robot-dexterity/tactile-bench/assets/Dobot MG400 rig/End flange/MG400 Calibration Servo Mount.stl

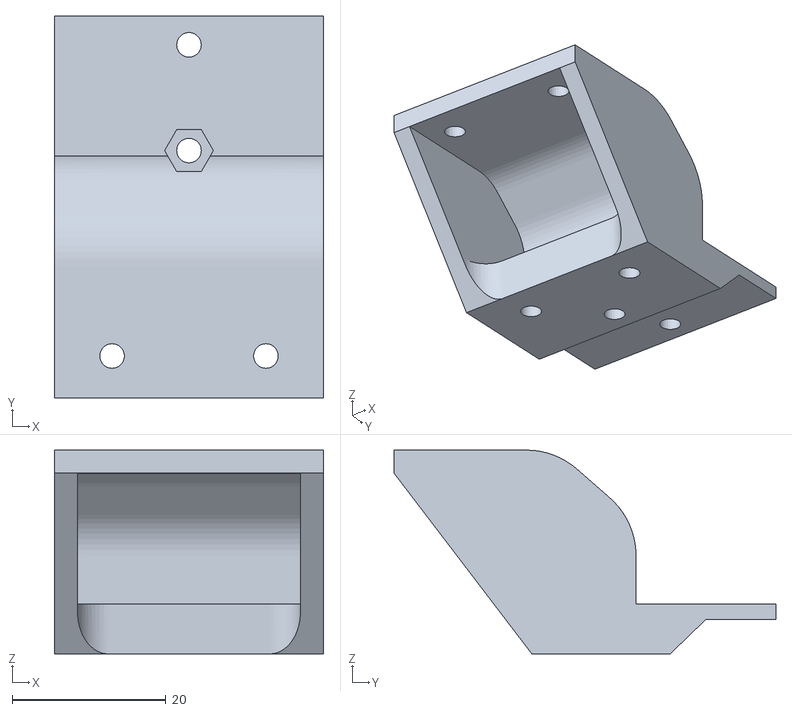
[picture p1: CAD file, 2026-10-21]
assets/Dobot MG400 rig/End flange/MG400 Calibration Servo Mount.stl
35.0 x 49.7 x 26.5
