robot-dexterity/tactile-bench/assets/Dobot MG400 rig/MG400 Baseplate setup with workspace.stl

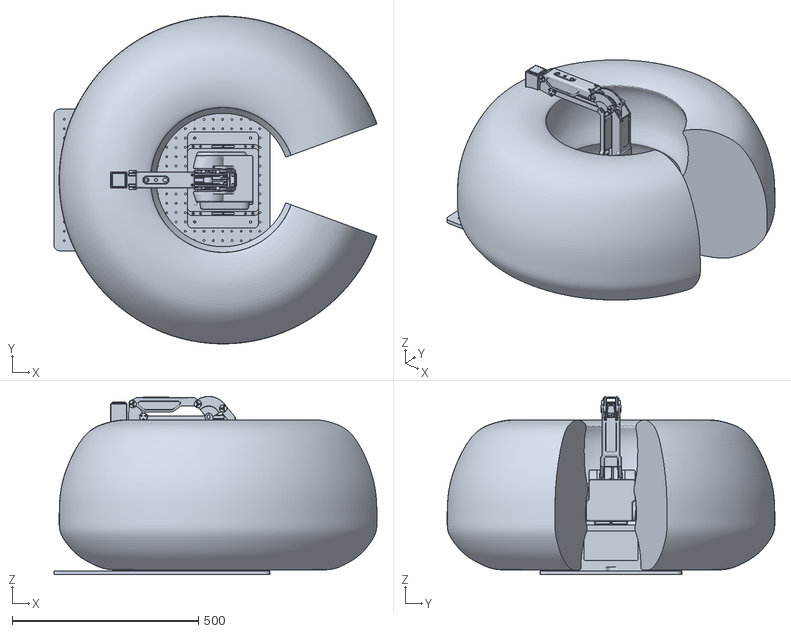
[picture p2: CAD file, 2026-10-21]
assets/Dobot MG400 rig/MG400 Baseplate setup with workspace.stl
866.7 x 879.4 x 478.0
