robot-dexterity/tactile-bench/assets/Dobot MG400 rig/Standoffs/52mmStandOff.step

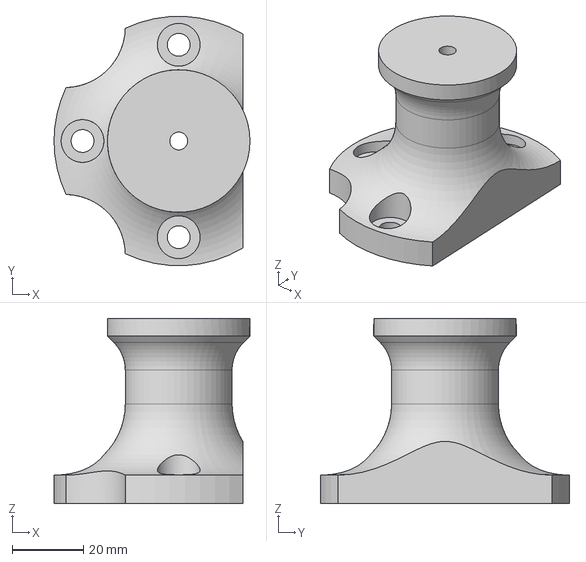
[picture p4: CAD file, 2026-10-21]
assets/Dobot MG400 rig/Standoffs/52mmStandOff.step
55.0 x 69.9 x 52.0 mm
