robot-dexterity/tactile-bench/assets/Dobot MG400 rig/End flange/MG400 End Flange.step

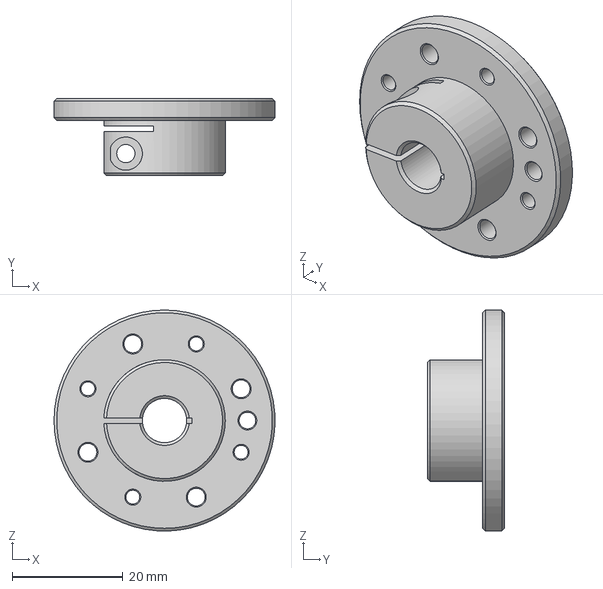
[picture p5: CAD file, 2026-10-21]
assets/Dobot MG400 rig/End flange/MG400 End Flange.step
40.0 x 14.0 x 40.0 mm
