robot-dexterity/tactile-bench/assets/Dobot MG400 rig/Mounting plates/BasePlate_400x600_v2.stl

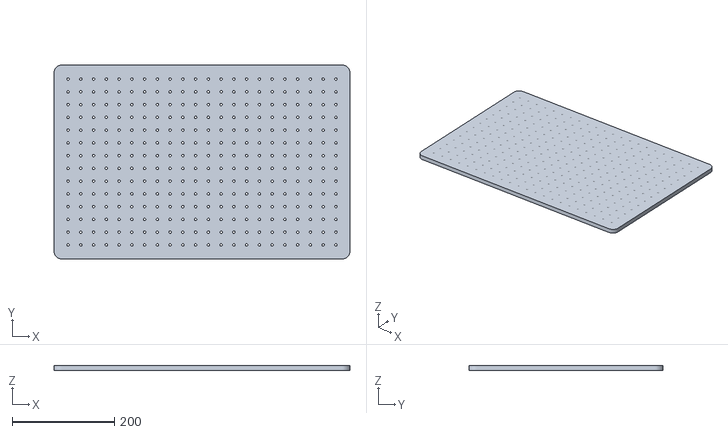
[picture p7: CAD file, 2026-10-21]
assets/Dobot MG400 rig/Mounting plates/BasePlate_400x600_v2.stl
580.0 x 380.0 x 10.0
