robot-dexterity/tactile-bench/assets/Dobot MG400 rig/Standoffs/100mm Pillar.step

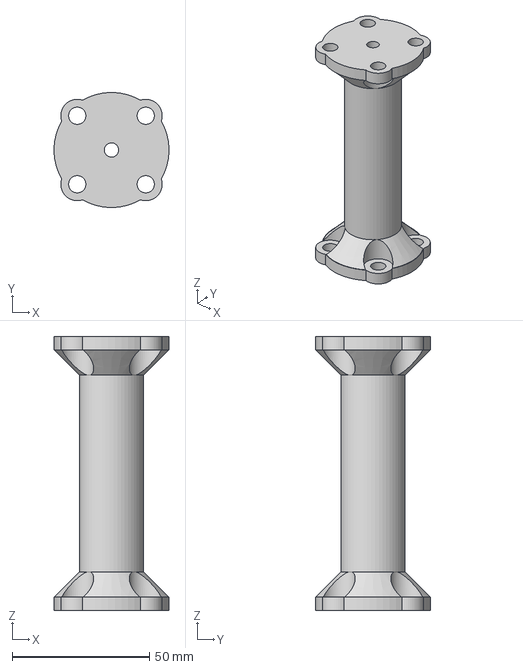
[picture p8: CAD file, 2026-10-21]
assets/Dobot MG400 rig/Standoffs/100mm Pillar.step
41.9 x 41.9 x 100.0 mm
