robot-dexterity/tactile-bench/assets/Dobot MG400 rig/Standoffs/100mmStandOff.stl

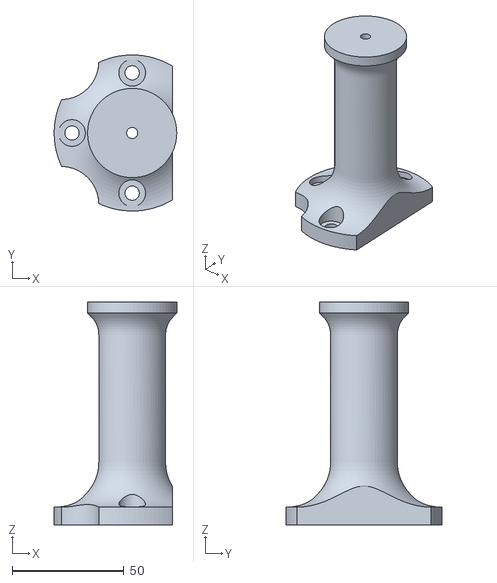
[picture p9: CAD file, 2026-10-21]
assets/Dobot MG400 rig/Standoffs/100mmStandOff.stl
55.0 x 70.0 x 100.0
