robot-dexterity/tactile-bench/(list of files, cad)

Other CAD files:
assets/Dobot MG400 rig/Mounting plates/MountPlate_MG400_v3.dxf
assets/Dobot MG400 rig/Standoffs/100mm Pillar.stl
assets/Dobot MG400 rig/Standoffs/52mmStandOff.stl
